ahmetcan-akuz/EE463_2022_Hardware_Project/PCB_Design/pcb_3d.png

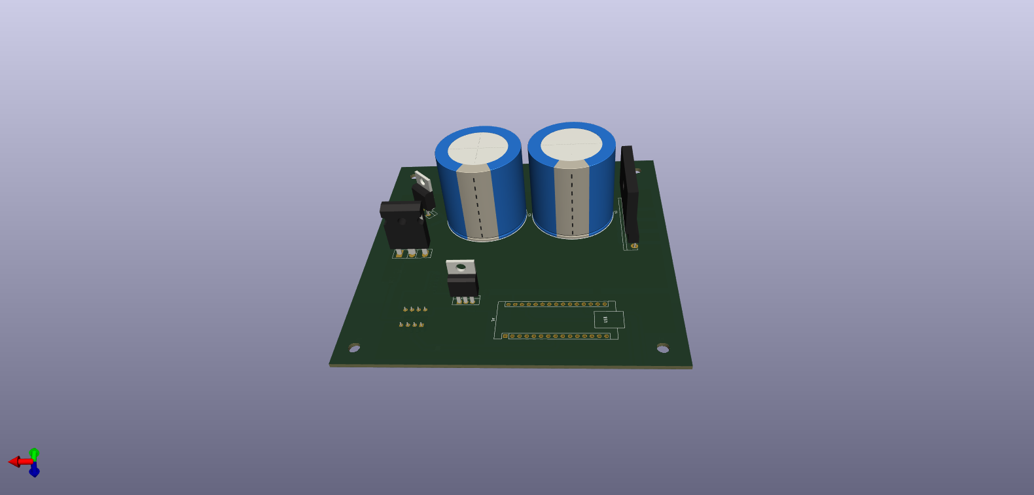
PCB_Design/pcb_3d.png
