ahmetcan-akuz/EE463_2022_Hardware_Project/Test Results/FLIR1296.jpg

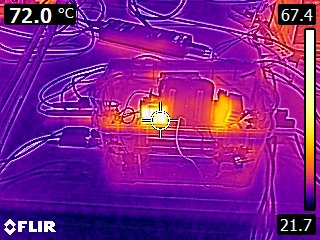
Test Results/FLIR1296.jpg
