ahmetcan-akuz/EE463_2022_Hardware_Project/README.md

# EE463_Hardware_Project
This is a repository of EE 463 Hardware Project. This project is designed by Ahmetcan Akuz, Utku Deniz Altıok and Ekin Arda Çömez.
