ahmetcan-akuz/EE463_2022_Hardware_Project/PCB_Design/pcb_v1.0.png

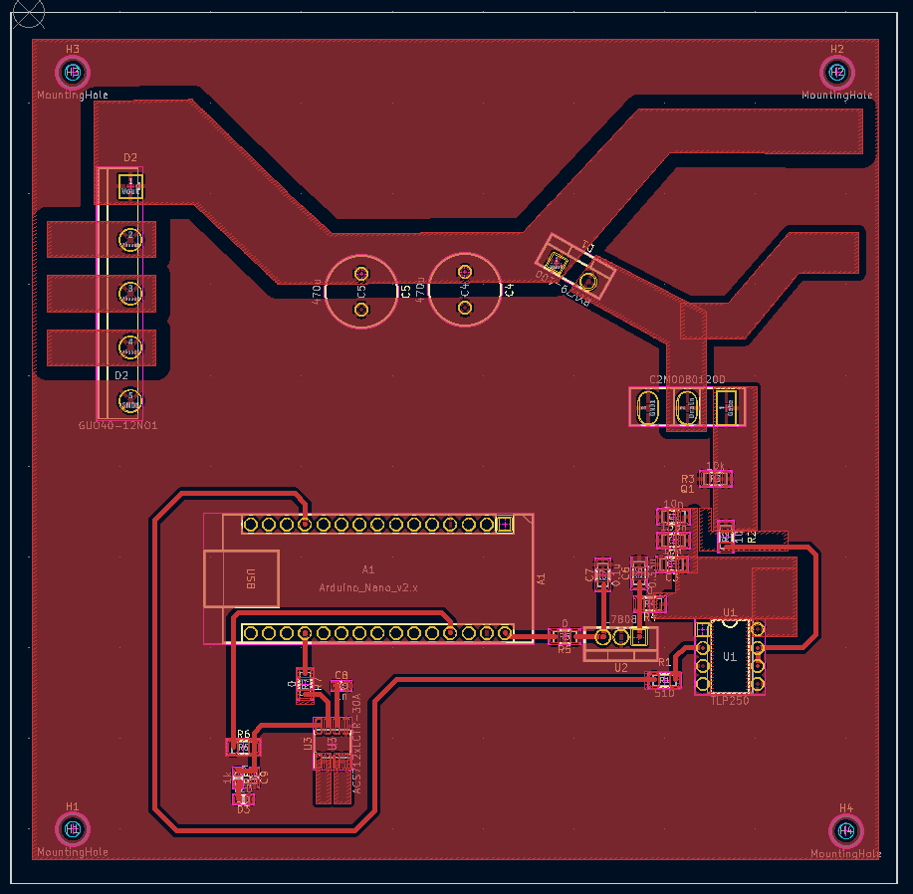
PCB_Design/pcb_v1.0.png
