ahmetcan-akuz/EE463_2022_Hardware_Project/PCB_Design/schematics.png

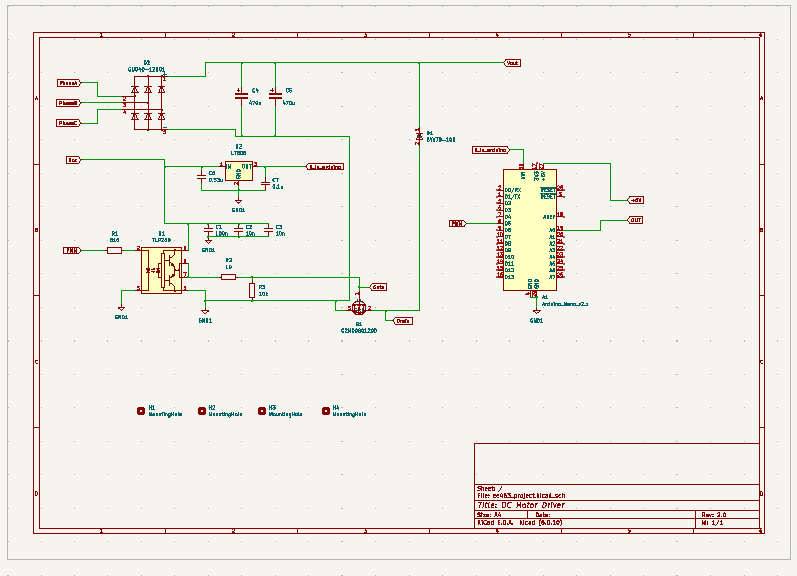
PCB_Design/schematics.png
