ahmetcan-akuz/EE463_2022_Hardware_Project/PCB_Design/Schematics.pdf

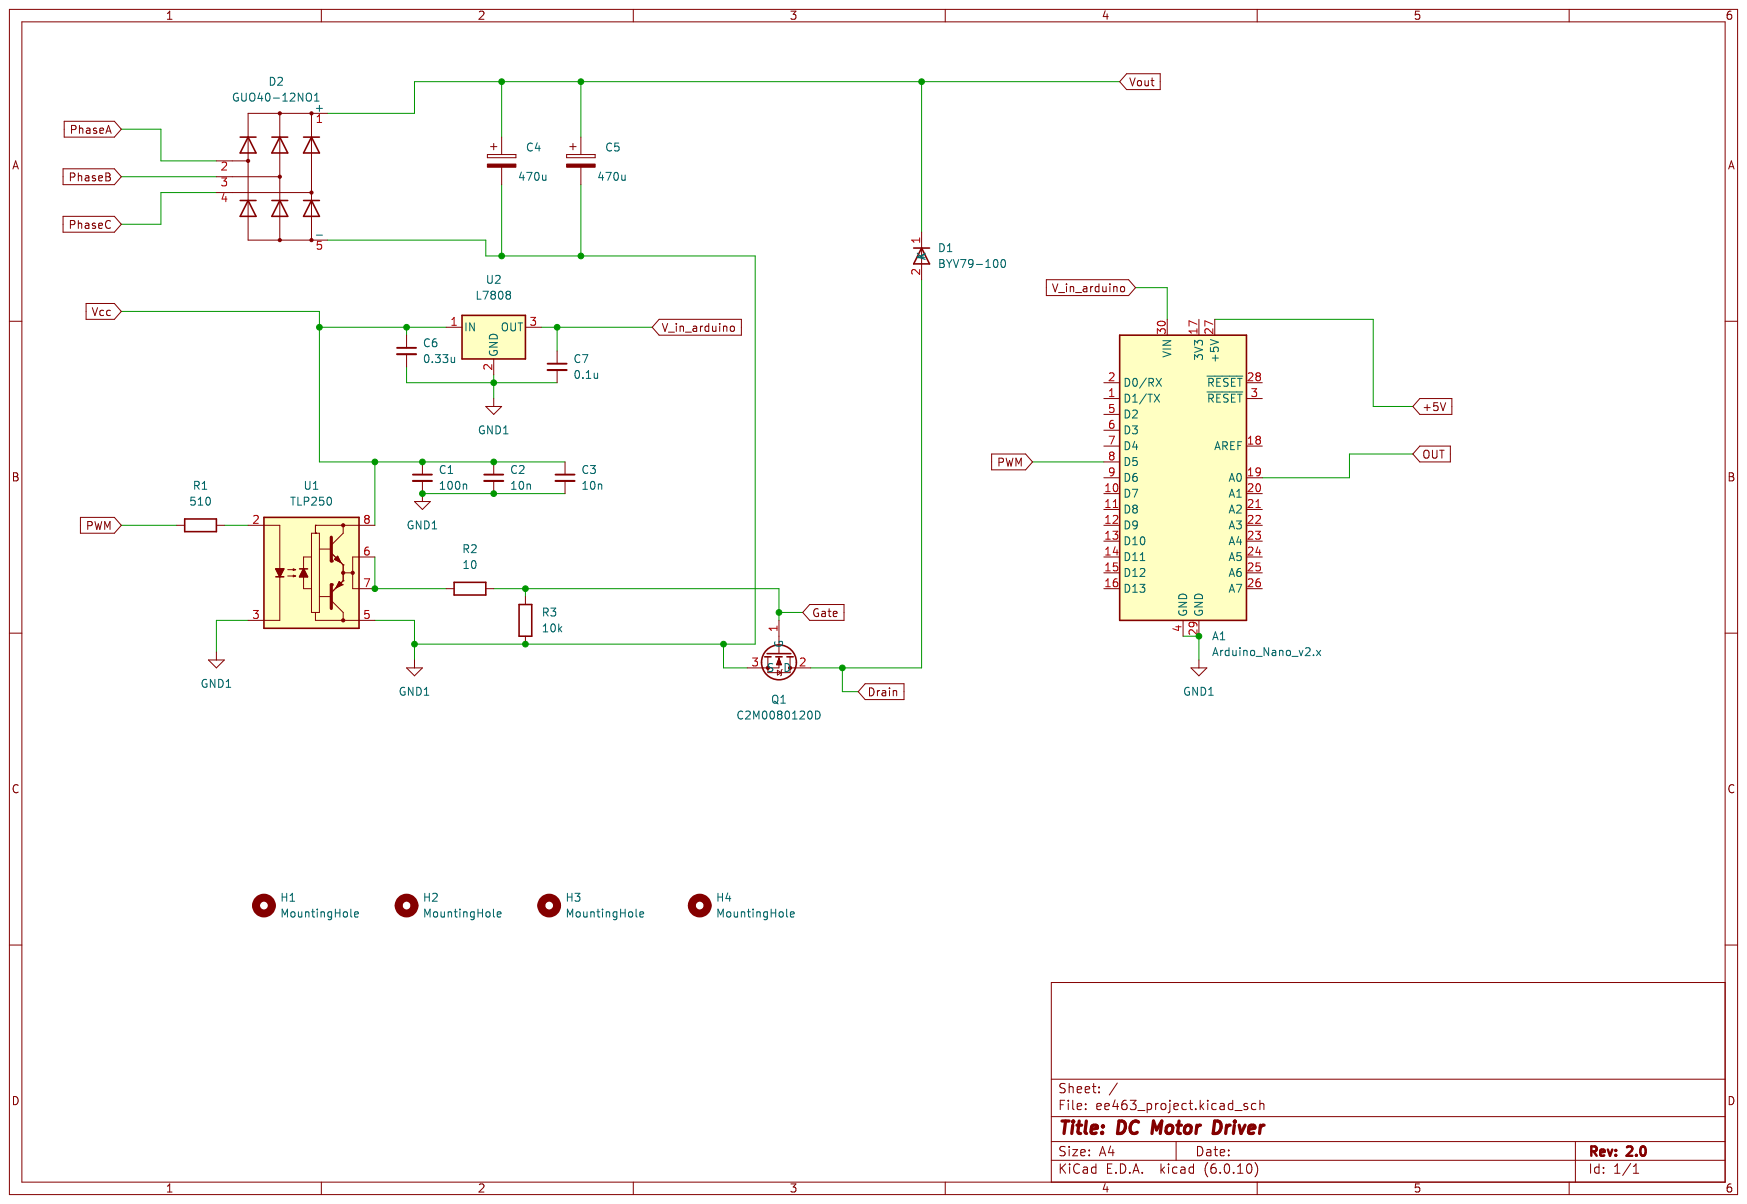
[picture p7: page 1]
