ahmetcan-akuz/EE463_2022_Hardware_Project/Components/LM555/LM555_Astable_Mode.asc

C1: cap; 10n
C2: cap; 1n
R1: res; 68k
R2: res; 8.2k
R3: res; 10
U1: NE555
V1: voltage; 12
Named nets: 0
.tran 10m
t_high=ln(2)(R1+R2)C2
t_low=ln(2)R2C
