ahmetcan-akuz/EE463_2022_Hardware_Project/Simulations/Gate_Driver/Gate_Driver.asc

10k: res; 10
D2: diode
M1: nmos; AO6408
R3: res; 510
R4: res; 20
R5: res; 10k
U1: 4N25
V1: voltage; PULSE(0 5 0 0 0 0.0005 0.001)
V2: voltage; 15
Named nets: 0
.tran 0 0.2 0 0.0001
