ahmetcan-akuz/EE463_2022_Hardware_Project/PCB_Design/ee463_project/v1.0/ee463_project.kicad_pcb

## KiCad design PCB_Design/ee463_project/v1.0/ee463_project.kicad_pcb (2023-01-04)

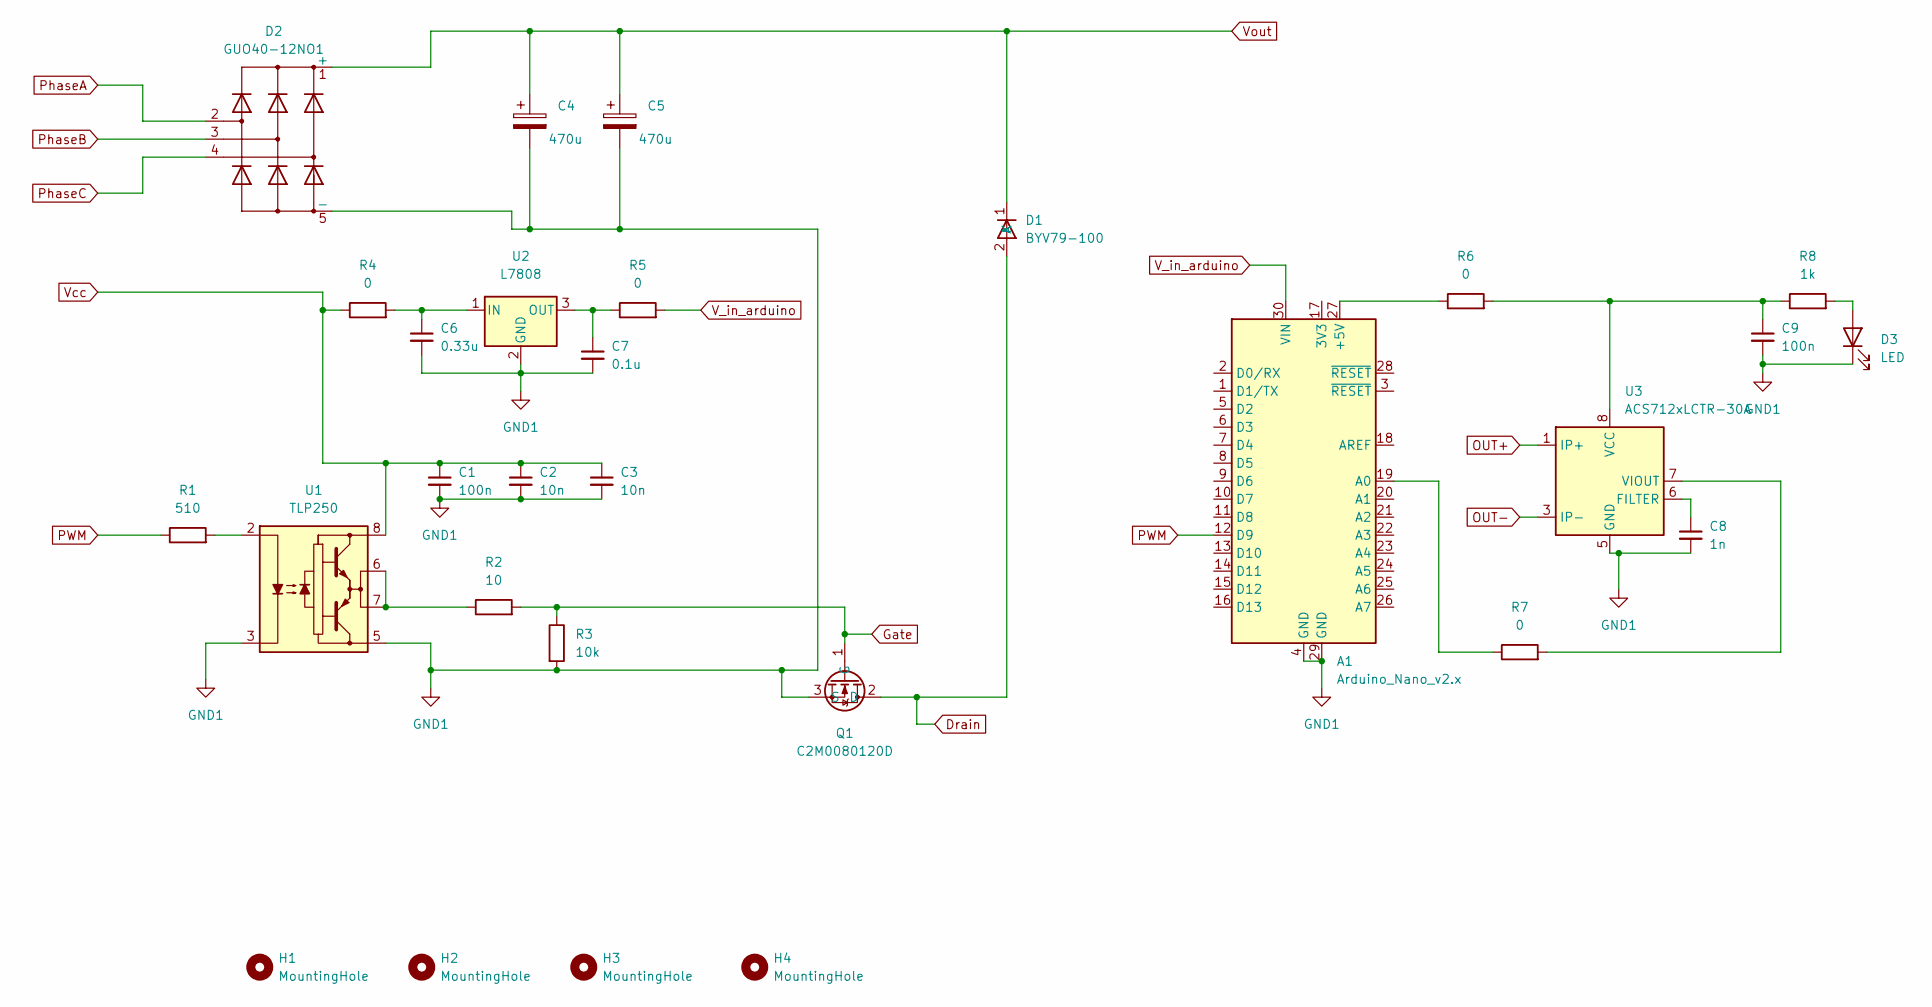
[picture p8: schematic ee463_project.kicad_sch]

Parts:
A1: Arduino_Nano_v2.x; Arduino_Nano
C1: 100n; C_1206_3216Metric
C2, C3: 10n; C_1206_3216Metric
C4, C5: 470u; C_Radial_D10.0mm_H16.0mm_P5.00mm
C6: 0.33u; C_1206_3216Metric
C7: 0.1u; C_1206_3216Metric
C8: 1n; C_0603_1608Metric
C9: 100n; C_0603_1608Metric
D1: BYV79-100; TO-220-2_Vertical
D2: GUO40-12NO1; Diode_Bridge_IXYS_GUFP
D3: LED; R_0603_1608Metric
H1, H2, H3, H4: MountingHole; MountingHole_2.2mm_M2
Q1: C2M0080120D; TO-247-3_Vertical
R1: 510; R_1206_3216Metric
R2: 10; R_1206_3216Metric
R3: 10k; R_1206_3216Metric
R4, R5, R6, R7: 0; R_1206_3216Metric
R8: 1k; R_0603_1608Metric
U1: TLP250; DIP-8_W7.62mm
U2: L7808; TO-220-3_Vertical
U3: ACS712xLCTR-30A; SOIC-8_3.9x4.9mm_P1.27mm

Connections:
Drain: D1.2 (A), Q1.2 (D)
GND1: A1.4 (GND), A1.29 (GND), C1.2, C2.2, C3.2, C4.2, C5.2, C6.2, C7.2, C8.2, C9.2, D2.5 (-), D3.1 (K), Q1.3 (S), R3.2, U1.3 (C), U1.5 (VEE), U2.2 (GND), U3.5 (GND)
Gate: Q1.1 (G), R2.2, R3.1
unnamed: A1.19 (A0), R7.1
unnamed: A1.27 (+5V), R6.1
unnamed: C6.1, R4.2, U2.1 (IN)
unnamed: C7.1, R5.1, U2.3 (OUT)
unnamed: C8.1, U3.6 (FILTER)
unnamed: C9.1, R6.2, R8.1, U3.8 (VCC)
unnamed: D3.2 (A), R8.2
unnamed: R1.2, U1.2 (A)
unnamed: R2.1, U1.6 (VO), U1.7 (VO)
unnamed: R7.2, U3.7 (VIOUT)
OUT+: U3.1 (IP+), U3.2 (IP+)
OUT-: U3.3 (IP-), U3.4 (IP-)
PWM: A1.12 (D9), R1.1
PhaseA: D2.2
PhaseB: D2.3
PhaseC: D2.4
V_in_arduino: A1.30 (VIN), R5.2
Vcc: C1.1, C2.1, C3.1, R4.1, U1.8 (VCC)
Vout: C4.1, C5.1, D1.1 (K), D2.1 (+)

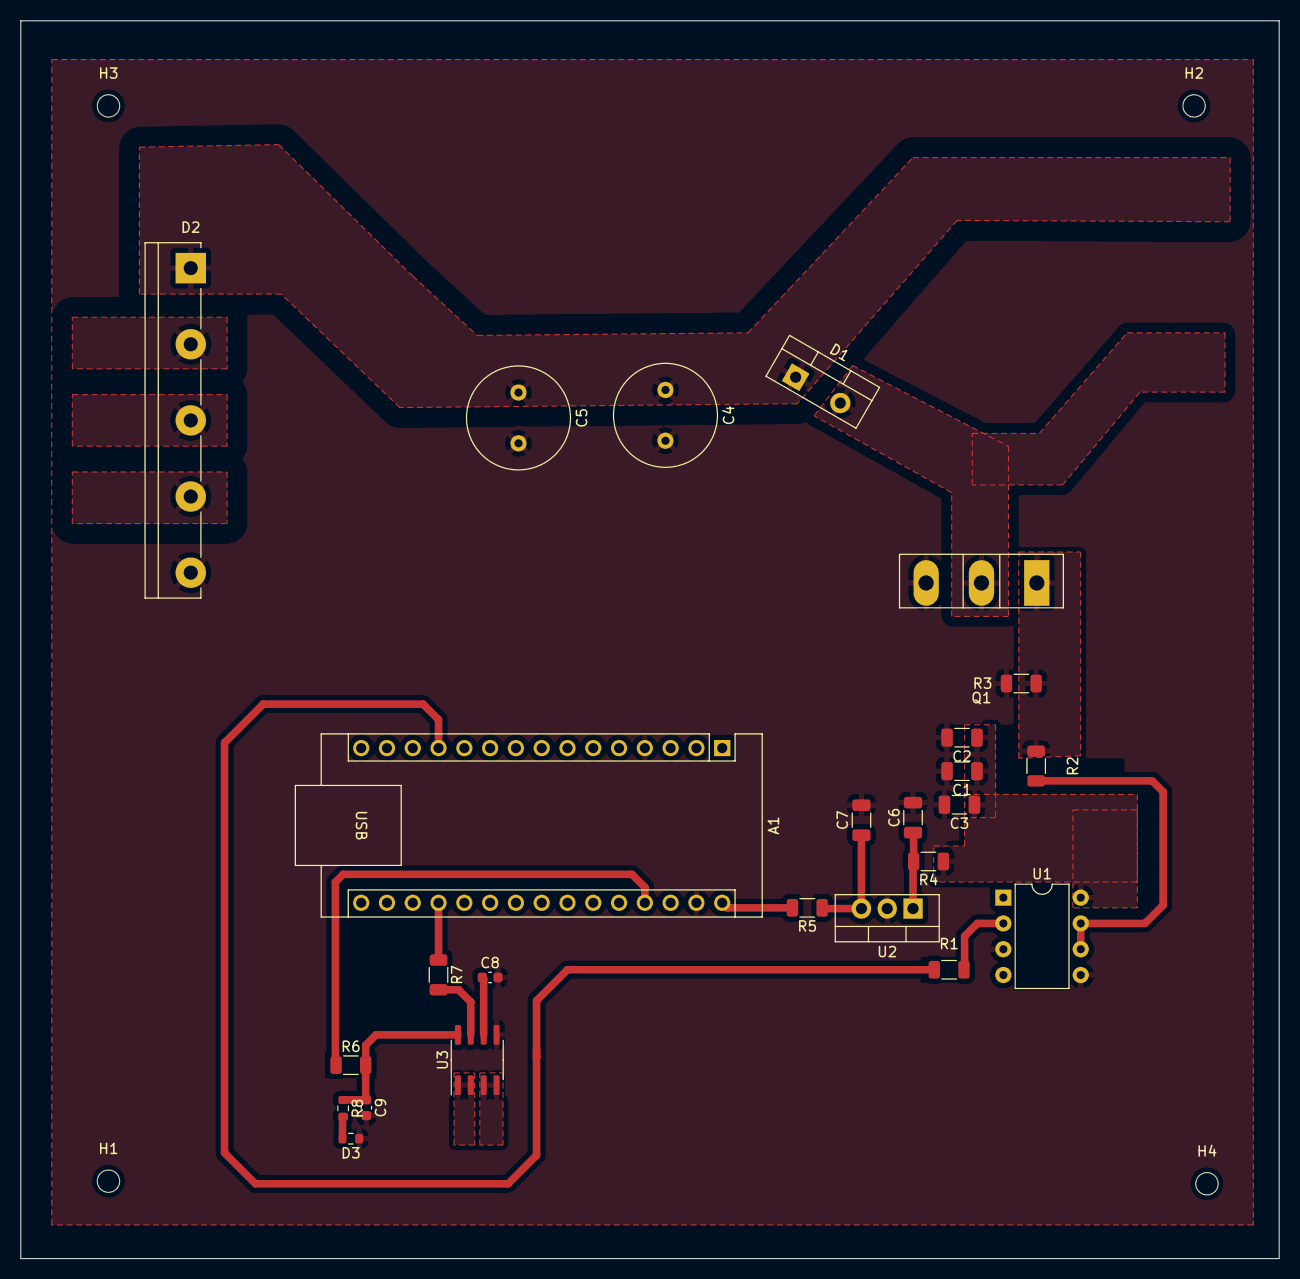
[picture p9: board ee463_project.kicad_pcb from above]

Board: 2 copper layers, 124.0 x 121.9 mm, 29 parts (0 on the bottom side), 19 nets.
