ahmetcan-akuz/EE463_2022_Hardware_Project/Test Results/dut_50.jpeg

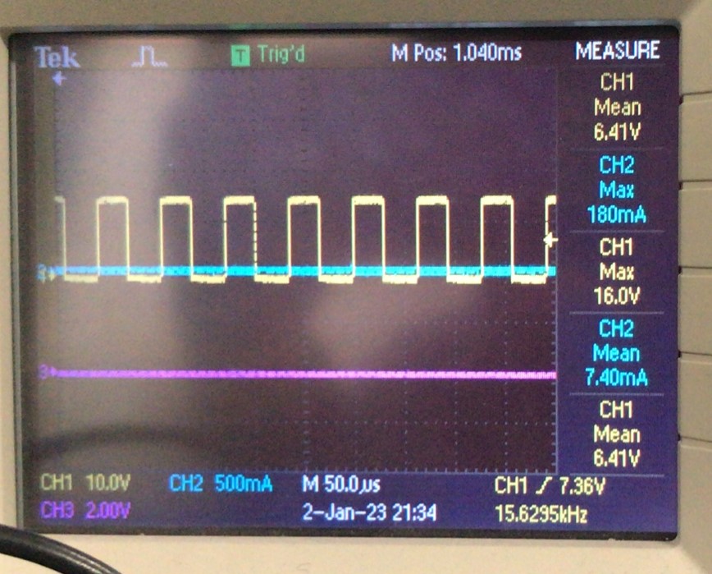
Test Results/dut_50.jpeg
