ahmetcan-akuz/EE463_2022_Hardware_Project/Test Results/duty_20.jpeg

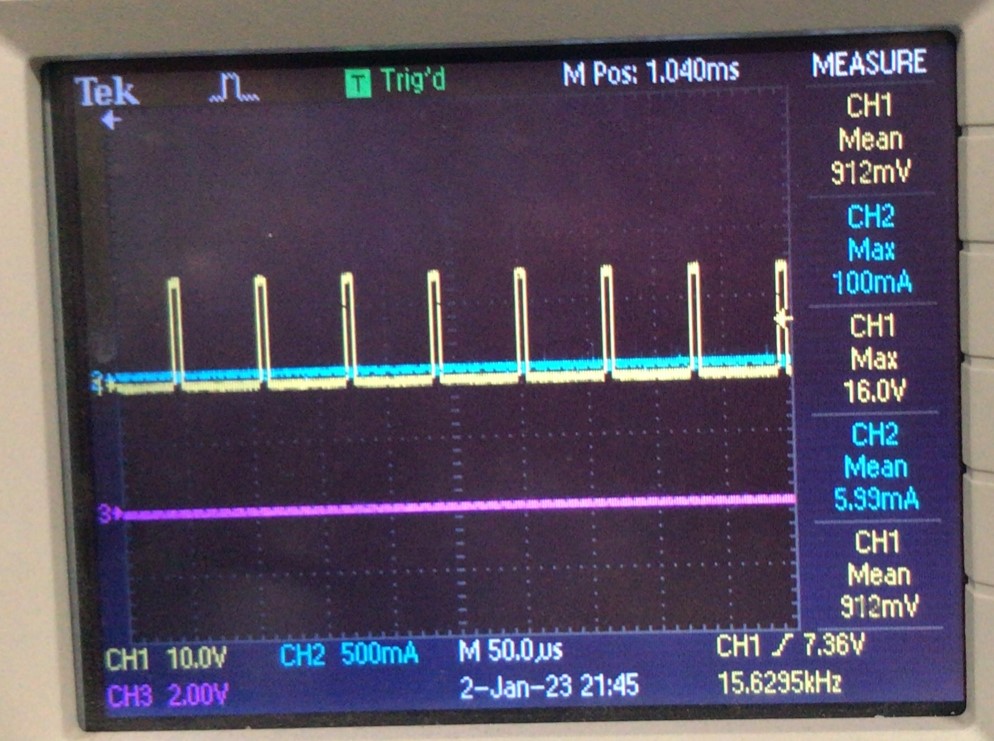
Test Results/duty_20.jpeg
