ahmetcan-akuz/EE463_2022_Hardware_Project/Test Results/duty_70.jpeg

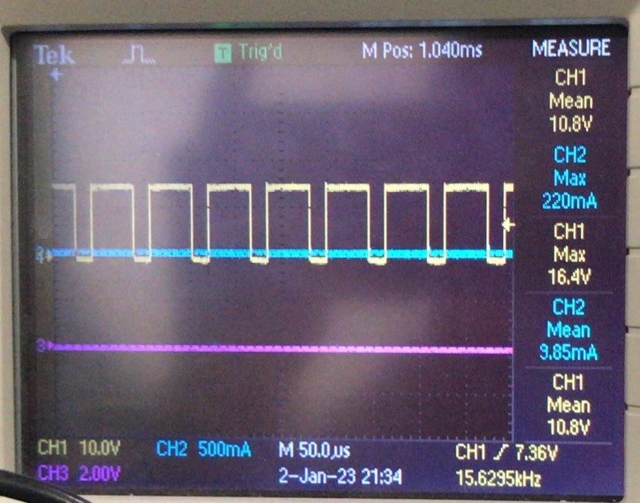
Test Results/duty_70.jpeg
