ahmetcan-akuz/EE463_2022_Hardware_Project/Test Results/gate_driver_test.jpeg

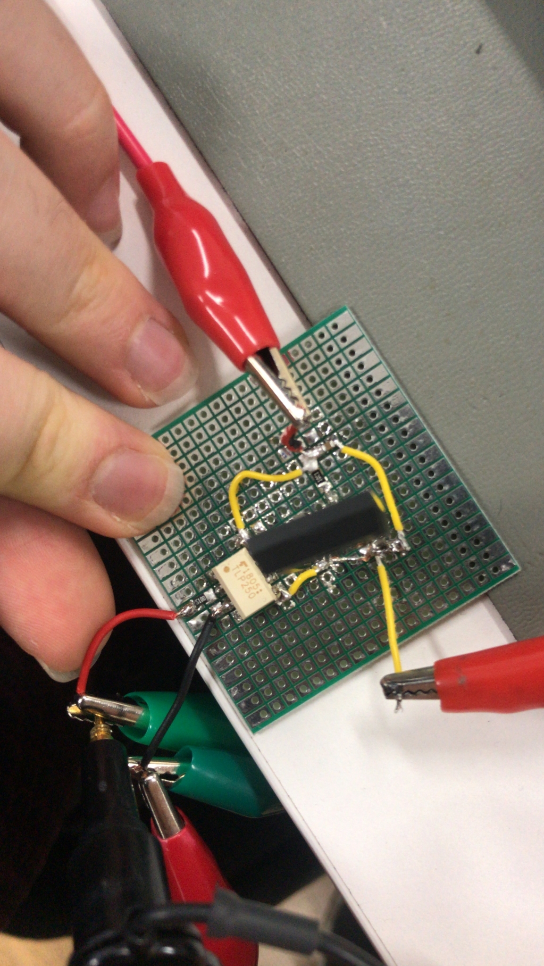
Test Results/gate_driver_test.jpeg
