ahmetcan-akuz/EE463_2022_Hardware_Project/Test Results/motor_fail_no_load.jpeg

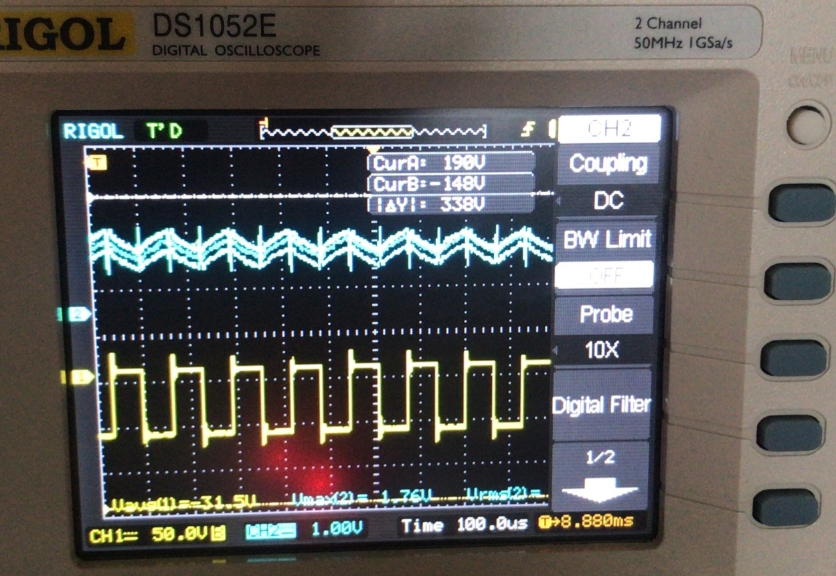
Test Results/motor_fail_no_load.jpeg
