ahmetcan-akuz/EE463_2022_Hardware_Project/Test Results/RL_load_fail.jpeg

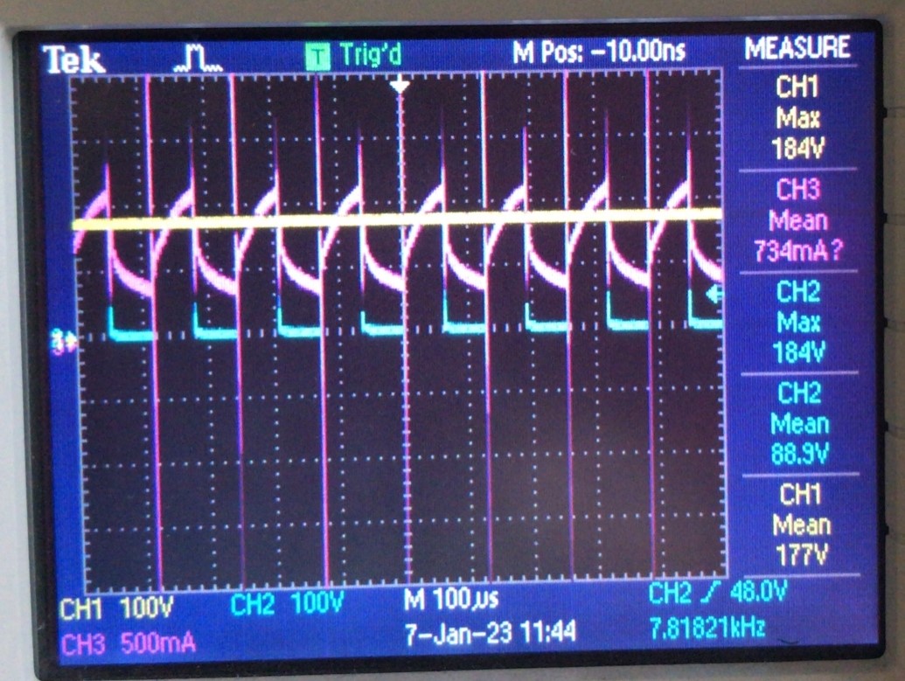
Test Results/RL_load_fail.jpeg
