ahmetcan-akuz/EE463_2022_Hardware_Project/Test Results/RL_load_last.jpeg

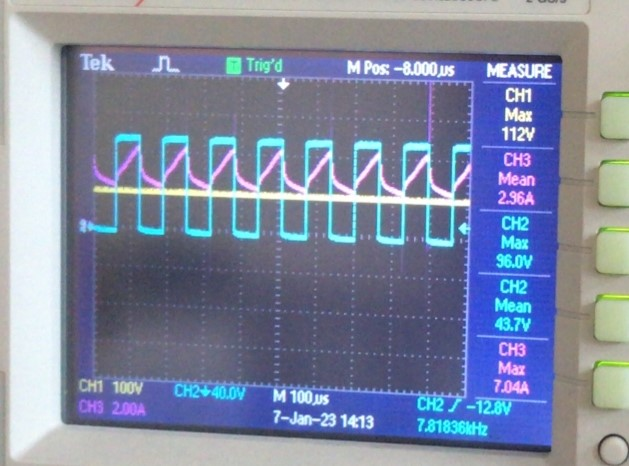
Test Results/RL_load_last.jpeg
