ahmetcan-akuz/EE463_2022_Hardware_Project/Test Results/RL_no_fail.jpeg

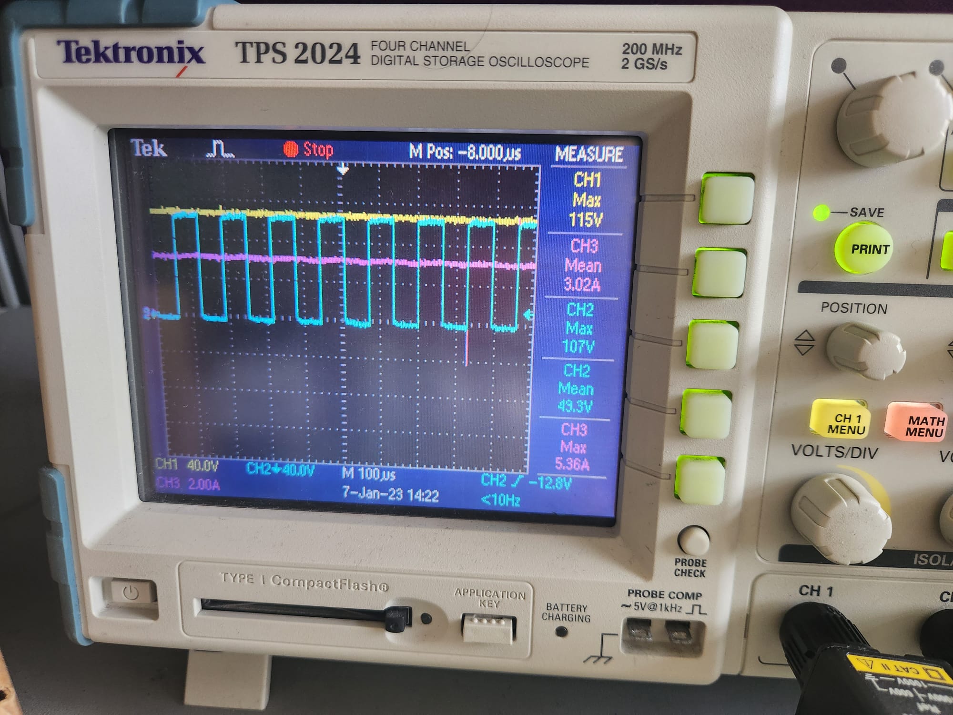
Test Results/RL_no_fail.jpeg
