ahmetcan-akuz/EE463_2022_Hardware_Project/(commit log)

2022-12-03 3Phase Diode Rect+DC/DC Converter
    Three phase diode rectifier + DC/DC converter simulation was added.
2022-12-04 Motor Model of the Given Motor
    (We will consider about using the DC Machine Block as well)
2022-12-06 Single Phase Thyristor Rectifier with filter
2022-12-06 Firing angle and LC filter updated.
    Firing angle has updated as 22 and output resistance has changed as 10 Ohm. Input voltage has also updated as 220Vrms
2022-12-06 Firing angle and output filter updated
2022-12-10 Three Phase Full Bridge + Buck with Motor Model at the end.
2022-12-23 We putted switching mosfet on the downside
2022-12-23 Low Side MOSFET Plexim Model
    Low Side MOSFET Plexim Model was added.
2022-12-24 TLP 250 Optocopuler Gate Driver Circuit
    We will use TLP250 as our non-inverting non-isolated gate driver circuit.
2022-12-24 Three Phase Full Bridge Diode Rectifier
2022-12-24 Si MOSFET FOR TRIAL PART
2022-12-24 TLP 250 Optocopuler Gate Driver Circuit
2022-12-24 SiC Diode
2022-12-24 Aurdino PWM Generating Code
2022-12-27 Gate Driver Simulation
    Optocoupler is working properly. However\ there 's a problem with buck converter topology.
2022-12-27 Gate Driver Passive Updated
    Input resistance updated to 500 Ohm. R2 updated1k to 10k.
2022-12-27 Gate Driver Experiment Procedure Added
    This is a procedure to observe switching performance of TLP250.
2022-12-28 Gate Driver Updated
2023-01-03 LT Spice Buck Converter Topology Added
    Buck converter topology was added to gate driver concept in simulation
2023-01-03 PCB Design
    PCB Design of the project in KiCad was added.
    [ee463_project.kicad_pcb, ee463_project.kicad_sch]
2023-01-04 PCB Completed Gerber Files Added
    [ee463_project.kicad_pcb, ee463_project.kicad_sch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]
2023-01-04 PCB Design Updated
    [ee463_project.kicad_pcb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]
2023-01-08 Delete Aurdino_Codes directory
    Addin final version of arduino codes
2023-01-08 Final Version of Arduino Codes
2023-01-14 PCB Update
2023-01-22 pcb figures added
