ahmetcan-akuz/EE463_2022_Hardware_Project/Test Results/overall_project.jpg

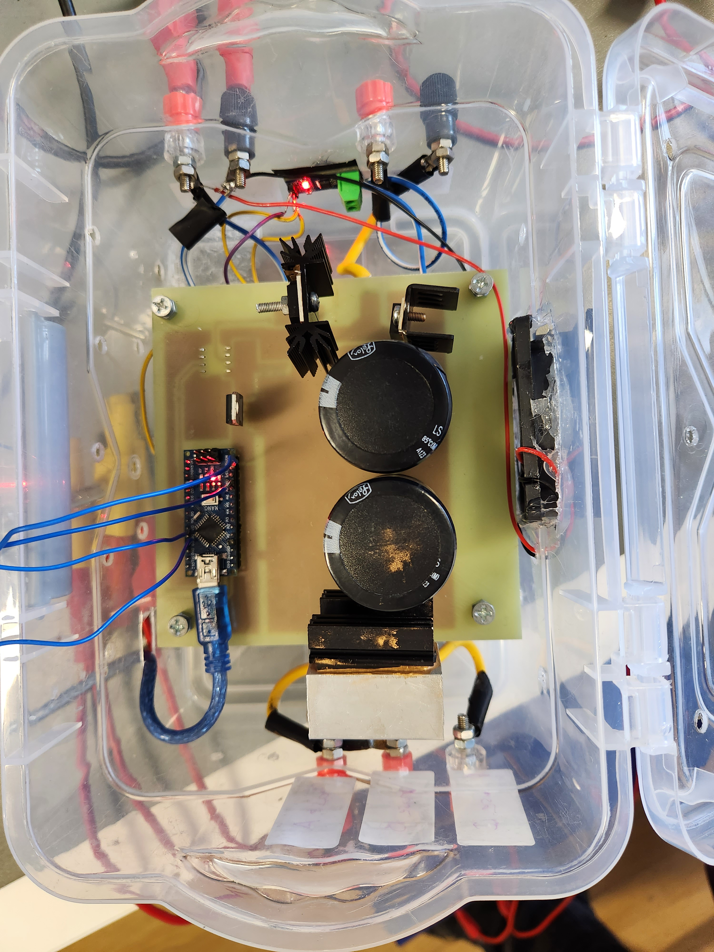
Test Results/overall_project.jpg
